RandomVertebrate/raspi-looper/(threads)

Thread 1 (2021-01-15):

Delay after FIRST record

RandomVertebrate, 2021-01-15:
Transition to playing from recording of the FIRST loop is not seamless; there is a half-second-ish delay. This is probably due to the time taken to write the audio to the loop and initialize things. Solution might be non-trivial.

phil291, 2021-05-30:
sd-cards are known not be slow, maybe putting raspios on a ram-disk can speed up the write process?

the volumio mediaplayer does this. another advantage of a ramdisk thingie is, that the looper can be powered off anytime without a worry, because all os-data is fresh copied from kinda template with every boot, so os-data cannot be messed up by the power off.

RandomVertebrate, 2021-05-30:
I imagine the audio data is currently being stored to the Raspberry Pi's
inbuilt RAM. Should this not be the case? I did not use any
write-to-disk/write-to-file methods, everything is stored in numpy array
variables (objects) in the script.

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

phil291, 2021-05-30:
i think it's worth a try, the audio framework of your project is quite complex, because it handles pulse plus alsa plus python.
to say everything audio is happening on ram can be kinda brave ;)

i can imagine there is some buffernig mechanics inside asla/pulse you cannot manipulate/handle inside python.
to me it seems this has been a topic in the volumio cummunity since their beginning, mainly because they have to deal with tons of different hifi-hardware rigs by beeing high quality audiophile freaks.

RandomVertebrate, 2021-05-30:
That's interesting. Thanks, I will look into RAMDISK, this is new territory
for me.

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

RandomVertebrate, 2021-06-16:
This issue is fixed now. I did it essentially by removing the "special" initialization method that only loop 1 was using. Loop 1 now uses the same function as all the other tracks for initialization.

Closed 2021-06-16.

Thread 3 (2021-01-18):

No way to restart

RandomVertebrate, 2021-01-18:
There is currently no way to end the current looping session and start a new one (record a new 'loop 1') without rebooting. This would be a useful feature.

Closed 2021-01-20.

Thread 4 (2021-01-20):

(Need to confirm) Deleting a track sometimes causes recording to start as well

RandomVertebrate, 2021-01-20:
Sometimes when I delete a track it starts recording on the next repeat of loop1. This is not 'supposed' to happen, so some debugging is in order perhaps.
Had some trouble recreating this intentionally so it might be a hardware thing or some probablilistic threading thing. Not going to do anything about this for the moment.

RandomVertebrate, 2022-03-07:
It was a noisy button release thing. Fixed after debouncing.

Closed 2022-03-07.

Thread 5 (2021-05-30):

specify default soundcard in alsa.conf

phil291, 2021-05-30:
using "2021-03-04-raspios-buster-armhf-full" i needed to change the index of the usb-soundcard in

/usr/share/alsa/alsa.conf

defaults.ctl.card 0
defaults.pcm.card 0
defaults.pcm.device 0

to

defaults.ctl.card 1
defaults.pcm.card 1
defaults.pcm.device 1

to get the main.py script working.

however, if i clear the first track, for example if i didn't like what i recorded, i'm not able to record again.

phil291, 2021-05-30:
and of course, great project, respect, thanks man!

RandomVertebrate, 2021-05-30:
This shouldn't be necessary if

a) you run device.py and setup.py and set the audio device index correctly
beforehand
b) you run everything as sudo

Had you done this? If so then there's something wrong. If you didn't run
the script as sudo then it won't work because the script won't be allowed
to switch audio devices (as far as I understand).

Let me know.

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

phil291, 2021-05-30:
i'm sorry, after pressing record and play of the first track together the looper is again ready to record, didn't figure that out.

regarding soundcard defaults:
i tried with a fresh image, did all the suggested updates (i have a touch-screen connected to the display-port), then did all console setups with sudo, did not work out.

firstly i noticed that the audio-out was routed to the raspberry headphone jack, not to the usb-card, so latency.py couldn't really measure anything, but still printed out 69ms and some other data.

secondly, after all script configuration the internal sound was still the default in alsa.conf and stayed like that after the reboot.
after correcting this, all ok.

RandomVertebrate, 2021-05-30:
`regarding soundcard defaults:
i tried with a fresh image, did all the suggested updates (i have a touch-screen connected to the display-port), then did all console setups with sudo, did not work out.`

So, just to be clear:
You installed the OS fresh, ran devices.py to look up the index for your USB soundcard, ran settings.py and input these device indices, then ran sudo main.py and it still did not work?

If so, I will try to recreate this issue ASAP.

phil291, 2021-05-30:
yes, exactly.

after settings.py, where i have set two times index 1 as input and output, i checked in the desktop-gui that still the headphone jack was active as output, but input was correctly set to my usb soundcard.

as mentioned, i'm using a touchscreen, i guess it's the desktop-gui that prevents the update via terminal by somehow keeping the internal sound device busy after a possible startup sound, which i actually did not hear, because nothing was plugged in in the headphone jack.

however, main.py, when started manually, complains via alsa-lib-message that there is no bcm-32yadayada-thingie, so intilization fails and the script stops.

i remember also there have been issues on the volumio player regarding startup sounds when it comes to activate a kodi plugin at boot, which fires up his own gui including sound device initialzation. maybe it's a good idea to disable startup-sounds via your settings.py and kill running device processes before changing the alsa configuration, if i'm right on this, but the easiest way would be to mention this topic in you documentation as most people will not have a gui running.

if i get some free time tomorrow i will send you a recording of that click sound. additionally i will doublecheck for clicks on tracks 2-4 using my guitar. if my theory is right, clicks should be noticable there, too.

Thread 6 (2021-05-30):

click sound when track 1 stops recording

phil291, 2021-05-30:
this applies only to track 1, it does not occur on tracks 2-4.
can't really say if it's a record or playback issue.

RandomVertebrate, 2021-05-30:
I don't know what this is. Could be distortion coincidence. Would
appreciate if you send me a recording.

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

phil291, 2021-05-30:
tried again with microphone, no click sound.
tried with guitar - click sound.

i suspect the click-sound occurs when i plug in my guitar, play, and there is still guitar sound when i stop recording. i noticed similiar clicking sounds when i did wave-file editing in audacity, for example.

i think the clicking occurs because by the end of the recorded audio-file there is wave data with volume very much higher than 0, but the loop starts with 0 bias, so when the loop starts again, there is a volume decrease from last value from guitar sound to zero after only one time tick (1s/44100).

same problem will be when starting a recording with already guitar sound, and stopping with no sound.

workaround could be be a kind of fade-out to zero bias within a couple of milliseconds when stopping the recording, and fading playback same way before looping.

phil291, 2021-05-30:
i think this will also address the clipping/mixing issue.

RandomVertebrate, 2021-05-30:
Does this always happen only at exactly the beginning of the loop?

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

RandomVertebrate, 2021-05-30:
> i suspect the click-sound occurs when i plug in my guitar, play, and there is still guitar sound when i stop recording. i noticed similiar clicking sounds when i did wave-file editing in audacity, for example.

A recording would really help me grasp what's going on here

phil291, 2021-06-06:
sorry for the delay, is there an easy way to save the recorded wave within main.py, maybe with an additional switch on another gpio? i do have a another one mounted, not in use yet.

i managed to eliminate distortions originated by the dc-power supply (the cheap soundcard i am using obviously doesn't filter out anything) by using a power bank battery for smartphones instead, but i only have a terrible mic, where it's pretty useless to record the recording again, the click sound isn't really noticable, also with my smartphone a recording isn't really usefull.

RandomVertebrate, 2021-06-07:
I think this is happening during mixing. It could in fact be due to a bias.

  here, this version of main.py should write the loops to files locally on
the raspberry pi sd card

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

phil291, 2021-06-09:
sorry, i don't see any link to the new main.py

RandomVertebrate, 2021-06-09:
Sorry about that. Here it is:
https://drive.google.com/file/d/1yup7ZvmRYKR9sxXXjtEui6w6-yp7NPIP/view?usp=sharing

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

phil291, 2021-06-12:
thanks for the main.py file, as expected, there is no click sound recorded:

https://ufile.io/antb0afw

when you open it in audacity you will see that the wave ends far above a bias of zero.
playing it in audacity brings up exactly the same click sound when the playing stops.
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

RandomVertebrate, 2021-06-14:
This is very interesting! What's more your fade-out, fade-in solution seems
to work in Audacity :)
I shall implement this into the python script soon.

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

RandomVertebrate, 2021-06-14:
To be clear, this only happens on track 1, right? And only on the first recording, not on the overdubs? because implementing it on overdubs would be much harder :P

phil291, 2021-06-14:
i will test on all tracks and overdubs, if i get some spare time today ;)

RandomVertebrate, 2021-06-14:
I don't really understand why it's happening; your explanation of the physics doesn't really align with the way I understand signal processing or vibration theory. I think maybe a more intuitive way to look at this might be in the frequency domain in terms of waterfall graphs.

Anyway, the fact remains that it is happening. I'll send you a modified script which adds fades to the beginning and end of the very first recording of track 1 but nowhere else. Then you can let me know where else the clicks occur.

phil291, 2021-06-14:
great, looking forward!

RandomVertebrate, 2021-06-14:
Hey, so I tried fade-outs and fade-ins but that doesn't really work in a looping context because you lose a bit of the beginning and end of your loop. So I added some code to keep track of the previously recorded buffer as an extra bit of audio at the beginning and made a cross-fade with that at the end. I also changed some stuff that was stopping the master track from recording again if it is cleared/deleted. I think that should work now though I'm not sure and I probably wouldn't do that. let me know if your issue seems sorted; if so I'll update the repository with this version.
https://drive.google.com/file/d/1YG_ADkp9vNCzgUf8BO1k8xKl17ZPeqIR/view?usp=sharing

phil291, 2021-06-16:
just tested on all 4 tracks, no clicksound anymore. great work!

RandomVertebrate, 2021-06-16:
Awesome :)
I'll update the repo with this version then and close this issue.

Closed 2021-06-16.

Thread 8 (2021-12-09):

Error in recreation

JustinWoods1, 2021-12-09:
Hello! Love the project.

I am trying to recreate, and get to the latency.py step with no issues. Here, our output starts to differ at the very end.
After the last JackShmReadWritePtr::...
Expression 'parameters->channelCount <=maxChans' failed in 'src/hostapi/alsa/pa_linux_alsa.c', line 1514
Expression 'ValidateParameters( inputParameters, hostApi, StreamDirection_In )' failed in 'src/hostapi/alsa/pa_linux_alsa.c', line 2818
Traceback (most recent call last):
  File "latency.py", line 83, in <module>
    stream_callback = test_callback
  File "/usr/lib/python3/dist-packages/pyaudio.py". line 750, in open
    stream = Stream(self, *args, **kwargs)
  File "usr/lib/python3/dist-packages/pyaudio.py", line 441, in __init__
    self._stream = pa.open(**arguments)
OSError: [Errno -9998] Invalid number of channels

Did you ever run into this issue? Could definitely use some help.

Thanks!

RandomVertebrate, 2021-12-09:
As I recall, this happened to me when I didn't run the scripts as sudo. I
think it has something to do with overriding default soundcard selection,
though it is likely that I am mistaken.

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

JustinWoods1, 2021-12-12:
Still running into this error even after running as sudo; any other ideas/recomendations?

RandomVertebrate, 2021-12-12:
Hm, couldn't say.

Could you post your output from devices.py and setup.py? That might provide
some insight.

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

RandomVertebrate, 2022-07-18:
Hey, so I recently found out that on newer RPi OS versions you have to uninstall pulseaudio to access ALSA. This is probably the problem. Try uninstalling pulse.
Sorry for the year-late response :P

Thread 9 (2022-06-25):

Raspberry Pi 3 installation - Button not subscriptable

7p33iyowt7, 2022-06-25:
Hello,

I installed your looper software on a fresh Raspberry Pi OS 64-bit installation, yet the Button objects do not seem to be subscriptable. After the setup I ran **main.py** and landed on an error complaining about the "Button" type:

`Expression 'err' failed in 'src/hostapi/alsa/pa_linux_alsa.c', line: 3355
Expression 'ContinuePoll( self, StreamDirection_In, &pollTimeout, &pollCapture )' failed in 'src/hostapi/alsa/pa_linux_alsa.c', line: 3907
Expression 'PaAlsaStream_WaitForFrames( stream, &framesAvail, &xrun )' failed in 'src/hostapi/alsa/pa_linux_alsa.c', line: 4285
ready
Traceback (most recent call last):
  File "/home/pi/raspi-looper/main.py", line 442, in <module>
    RECBUTTONS[0].wait_for_press()
TypeError: 'Button' object is not subscriptable
`

python3-gpiozero is already the newest version (1.6.2-1). Do you know if this might be caused by some other python library changes or have any other direction to give?

Thanks

Closed 2022-06-25.

Thread 14 (2024-10-24):

2 leds light up and that is it

ihavenofuckingclue, 2024-10-24:
I am making this looper for a school project and whenever I power it only the GPIO 2 and GPIO 3 leds light up, and that's it. Nothing else functions. I have checked all hardware and software and it seems fine. The only difference that I have found is that I am using a raspberry pi 5 instead of 4b. Is there anything that would cause just 2 leds to light up within the raspberry pi?

RandomVertebrate, 2024-11-13:
Hey, apologies for the delayed response. If you're still interested in the project perhaps you could post some output and I will see If I can figure anything out. I have never tried this on a Pi 5 personally, though, so I am not confident I will be able to help.

ihavenofuckingclue, 2024-11-14:
No worries! I did fix it, just needed to mess around in rc.local a little. Instead of having the script change the directory then run main.py I just ran it direct by doing something like sudo python3 user/admin/raspi-looper/main.py.

Closed 2024-11-14.

Thread 15 (2024-10-28):

Help with Jack connection

modante, 2024-10-28:
Hello :-)
First of all, thank you very much for your project. It has inspired me to make some mods to your code in order to adapt it to my needs.

I have changed the 8 buttons (4 for play, 4 for rec) to 6:
-Rec
-Mute
-Undo
-Prev (change to the previous loop number)
-Next (change to the next loop number)
-Restart (changes mode from Looper to Fluidsynth
and I have added 10 audioloops instead of 4.

Also I only use 4 Led:
Leds on Rec Button: Yellow (red+green) when waiting and Red when recording
Leds on Mute Button: Yellow when waiting for UnMute and Green when Playing

I have implemented a is_waiting_play state in order to wait till readp == 0 to unmute the loop.

I share all my codes here because I don't know (I am a newby programmer) where I can share them.
[raspi-looper-mod.zip](https://github.com/user-attachments/files/17540497/raspi-looper-mod.zip)

The question is that I would like to adapt the code to run over jack instead of using PyAudio for two reasons:
- I would like to run simultaneously the looper and the fluidsynth
- I am using a Zoom H5 like USB audio interface and I need looper to capture the sum of the 4 mono audio inputs in order to use different instruments and mics connected to the physical inputs of the interface

I can see on this code that each block of 512 kb (buffer/chunk) it runs the looping_callback:
`looping_stream = pa.open(
    format = FORMAT,
    channels = CHANNELS,
    rate = RATE,
    input = True,
    output = True,
    input_device_index = INDEVICE,
    output_device_index = OUTDEVICE,
    frames_per_buffer = CHUNK,
    start = True,
    stream_callback = looping_callback
)`

Is there any easy way to adapt this code to Jack Client for Python? (https://jackclient-python.readthedocs.io/en/0.5.4/usage.html)

Thank you very much for your effort that is changing my setup like musician :-)

modante, 2024-10-28:
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

RandomVertebrate, 2024-11-05:
Hey! Just saw this. Great to see your project!
From what I can see of the jack documentation it seems compatible. The code would need to be changed to fit with how jack works. As to where you can share your code, if you click "fork" while logged into github it will create a new copy of the repository that you own that you can make changes to etc. and it will help you keep track of changes.

modante, 2024-11-12:
> Hey! Just saw this. Great to see your project! From what I can see of the jack documentation it seems compatible. The code would need to be changed to fit with how jack works. As to where you can share your code, if you click "fork" while logged into github it will create a new copy of the repository that you own that you can make changes to etc. and it will help you keep track of changes.

Hello :-D
I have created a new project because I am not sure how to do the fork when I have changed the code to adapt it to my hardware: https://github.com/modante/Raspi-Loop-Station
There is a "working" version of the adapted raspi-looper with pyAudio using 3 momentary buttons for Rec, Mute/Solo and Undo/Clear and 3 latched buttons (it is what I have at the moment, I will change them soon) for PrevLoop, NextLoop, and Mode (there is a Mode where FluidSynth runs an instance and PrevLoop and NextLoop Buttons changes the preset).
Then I have made a first version using Jack Client but still doesn't work: https://github.com/modante/Raspi-Loop-Station/tree/Jack-Implementation
I have a problem with buffers. I am not sure if the input buffer is been recorded on current_rec_buffer (line 540) or the play_buffer is been copied in the output_port.get_array() (line 616). The result is always silence.
Please, take a look at these lines. Maybe you get the trick at first sight.
Thank you very much :-)

modante, 2024-11-13:
Hi :-)
Definitively I have solved the jack connection and added FluidSynth to the Looper.
I made a fork of your work and recently I uploaded all the files to the repository:
https://github.com/modante/LooPyStation

Thank you very much for your inspiring project :-D

Closed 2024-11-13.

Thread 16 (2025-04-02):

All the LEDs light up

Astarof, 2025-04-02:
Hi,
Thank you for your work and for your time.
I turned it on for the first Time today and I have an issue.
All the LEDs light up when the script starts and nothing happens when I press the footswitches.
Can you help me.
Thanks a lot.

Hervé

Astarof, 2025-04-05:
Solved.
