RandomVertebrate/raspi-looper/(commit log)

2021-01-20 restart now possible
    holding record on track 1 restarts the main.py looper script
2021-06-16 Fixed Initial Delay
    Just got rid of a bunch of unnecessary code basically
    [main.py]
2021-06-17 Fixed Mixing Distortion
    Mostly fixed mixing distortion using adaptive output gain. Overdub distortion can still happen.
    [main.py]
2022-03-07 Implemented button debounce
    debounce implementation contd
2022-07-18 Update README.md
    Changed installation instructions to account for changes in the Raspberry Pi OS.
2023-12-26 Button refresh rate
2023-12-29 Input attenuation to prevent overdub clipping
    [main.py]
2023-12-29 Code refactoring of main.py - phase 2 (#13)
    * Code refactoring of main.py - phase 2
    * Volume update moved to button release event
    * Volume update moved to button release event
    ---------
